mfacton/treadwall/README.md

# treadwall
Electronics for lightable rotating rockwall
