mfacton/treadwall/notes.txt

https://treadwallfitness.com/
very thin electronics (plates are close)
not too tall (plates fold next to eachother)
beware of screw holes for rock mounting

12V power rail regulated to 5V for each row
resistors for leds 5V-> around 3V
all wires connect daisy chained (easy to fit all types)

have boards on the side of the treadmil for easy maintinence
also possibly brushed design

center slip ring is a possibility too:
https://www.amazon.com/Wires-250RPM-0-600V-Turbine-Generator/dp/B07KT8VT49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

preferably 3 connectors: 2 for power 1 for communication
probably put a processor on the outer adapter board
use only arduinos for easy configuration by users

cheap 12V power supply (like laptop barrel jack connector)
https://www.amazon.com/LEDMO-Power-Supply-Transformers-Adapter/dp/B01461MOGQ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

2 shift registers for up to 10 leds per row

LED RGBW 80mA per channel: C7371891
38mA LED RGBW driver: C20622183

JST PH Connectors: C157929
JST PH Housing: C495663

cable current = 8*40mA = 500mA rated wires
could be JST XH or PH

48*8 = ~400 LEDS
PCBs are about 80$

Single LED = 0.045$(Driver) + 0.035$(LED) = 0.08$
Total LED = 400*0.08$ = 35$

Harnessing
Connectors = 400*2*0.02$ = 16$
Housings = 400*2*0.022$ = 20$
48*7*3 = ~1000 Precrimped Wires
Wire Cost = 225$(Digikey)
Wire Cost = 150$(alibaba)
https://www.aliexpress.us/item/3256804150631941.html

Total LED system cost
80$(PCB) + 35$(components) + 150$(harnessing)
Total = 300$
