mfacton/treadwall/pcb/light-board/light-board.kicad_pcb

## KiCad design pcb/light-board/light-board.kicad_pcb (2024-07-15)

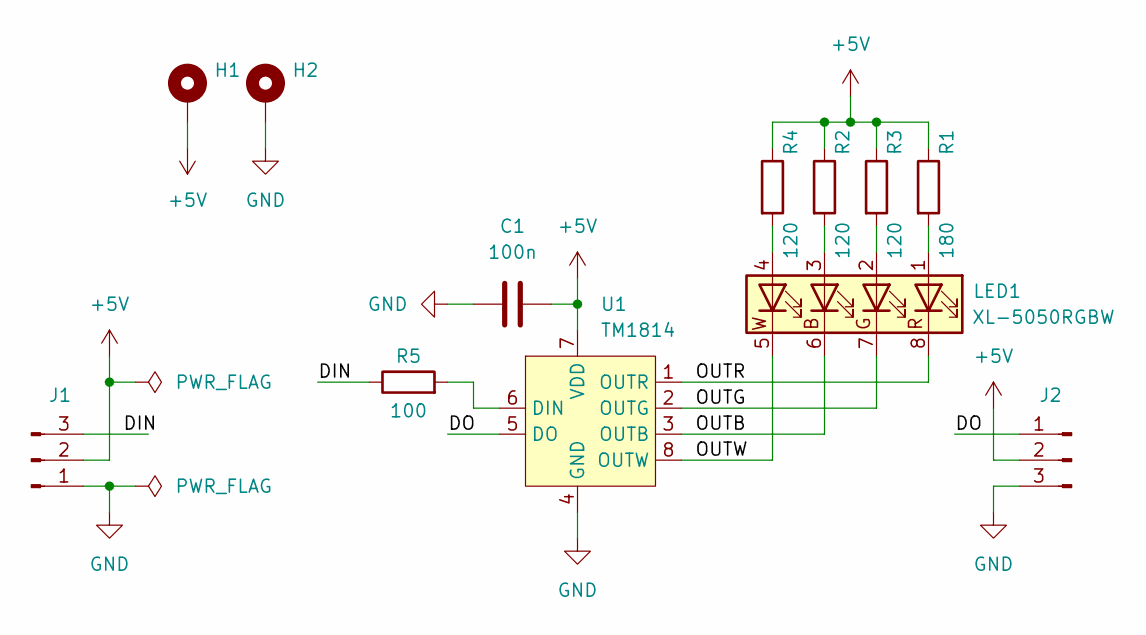
[picture p1: schematic light-board.kicad_sch]

Parts:
C1: 100n; C_0402_1005Metric; LCSC C1525
H1, H2: MountingHole_Pad; MountingHole_3.2mm_M3_Pad
J1, J2: Conn_01x03_Pin; JST_PH_S3B-PH-K_1x03_P2.00mm_Horizontal; LCSC C157929
LED1: XL-5050RGBW; LCSC C7371891
R1: 180; R_0603_1608Metric; LCSC C22828
R2, R3, R4: 120; R_0603_1608Metric; LCSC C22787
R5: 100; R_0402_1005Metric; LCSC C25076
U1: TM1814; SOP-8_3.9x4.9mm_P1.27mm; LCSC C20622183

Connections:
+5V: C1.2, H1.1, J1.2, J2.2, R1.1, R2.1, R3.1, R4.1, U1.7 (VDD)
/DIN: J1.3, R5.1
/DO: J2.1, U1.5 (DO)
/OUTB: LED1.6 (BK), U1.3 (OUTB)
/OUTG: LED1.7 (GK), U1.2 (OUTG)
/OUTR: LED1.8 (RK), U1.1 (OUTR)
/OUTW: LED1.5 (WK), U1.8 (OUTW)
GND: C1.1, H2.1, J1.1, J2.3, U1.4 (GND)
unnamed: LED1.3 (BA), R2.2
unnamed: LED1.2 (GA), R3.2
unnamed: LED1.1 (RA), R1.2
unnamed: LED1.4 (WA), R4.2
unnamed: R5.2, U1.6 (DIN)

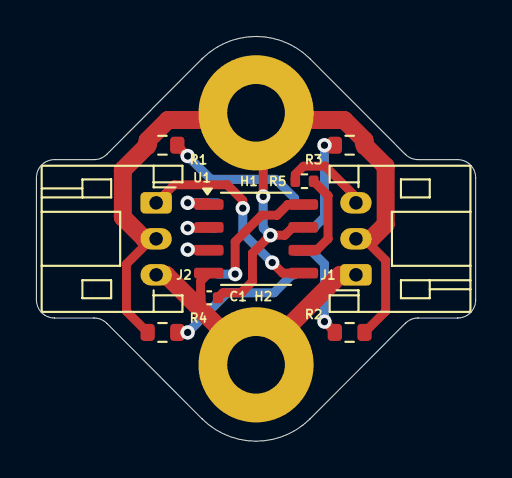
[picture p2: board light-board.kicad_pcb from above]

Board: 2 copper layers, 24.4 x 22.5 mm, 12 parts (1 on the bottom side), 13 nets.
