mfacton/treadwall/pcb/power-node/power-node.kicad_pcb

## KiCad design pcb/power-node/power-node.kicad_pcb (2024-07-11)

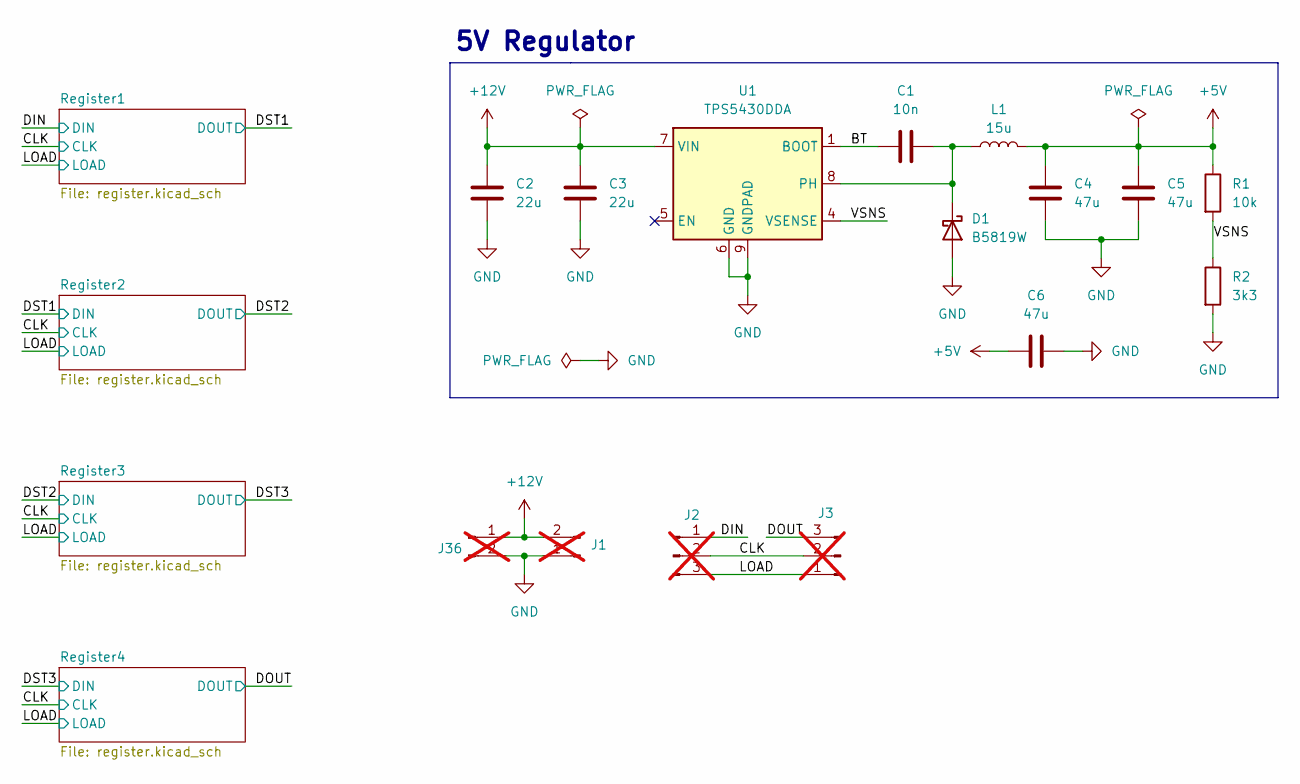
[picture p3: schematic power-node.kicad_sch]

Parts:
C1: 10n; C_0402_1005Metric; LCSC C15195
C2, C3: 22u; C_1206_3216Metric; LCSC C12891
C4, C5, C6: 47u; C_1206_3216Metric; LCSC C96123
D1: B5819W; D_SOD-123; LCSC C8598
J1, J36: Conn_01x02_Pin; WJ126V-5.0-2P; LCSC C8404; not fitted
J2, J3: Conn_01x03_Pin; PinHeader_1x03_P2.54mm_Vertical; not fitted
L1: 15u; L_Abracon_ASPI-0630LR; LCSC C177243
R1: 10k; R_0402_1005Metric; LCSC C25744
R2: 3k3; R_0402_1005Metric; LCSC C25890
U1: TPS5430DDA; TI_SO-PowerPAD-8_ThermalVias; LCSC C9864

Connections:
+5V: C4.1, C5.1, C6.1, L1.2, R1.1; also elsewhere on the board
+12V: C2.1, C3.1, J1.2, J36.1, U1.7 (VIN)
/BT: C1.1, U1.1 (BOOT)
/CLK: J2.2, J3.2; also elsewhere on the board
/DIN: J2.1; also elsewhere on the board
/DOUT: J3.3; also elsewhere on the board
/LOAD: J2.3, J3.1; also elsewhere on the board
/VSNS: R1.2, R2.1, U1.4 (VSENSE)
GND: C2.2, C3.2, C4.2, C5.2, C6.2, D1.2 (A), J1.1, J36.2, R2.2, U1.6 (GND), U1.9 (GNDPAD); also elsewhere on the board
unnamed: C1.2, D1.1 (K), L1.1, U1.8 (PH)

Notes on the sheet:
5V Regulator

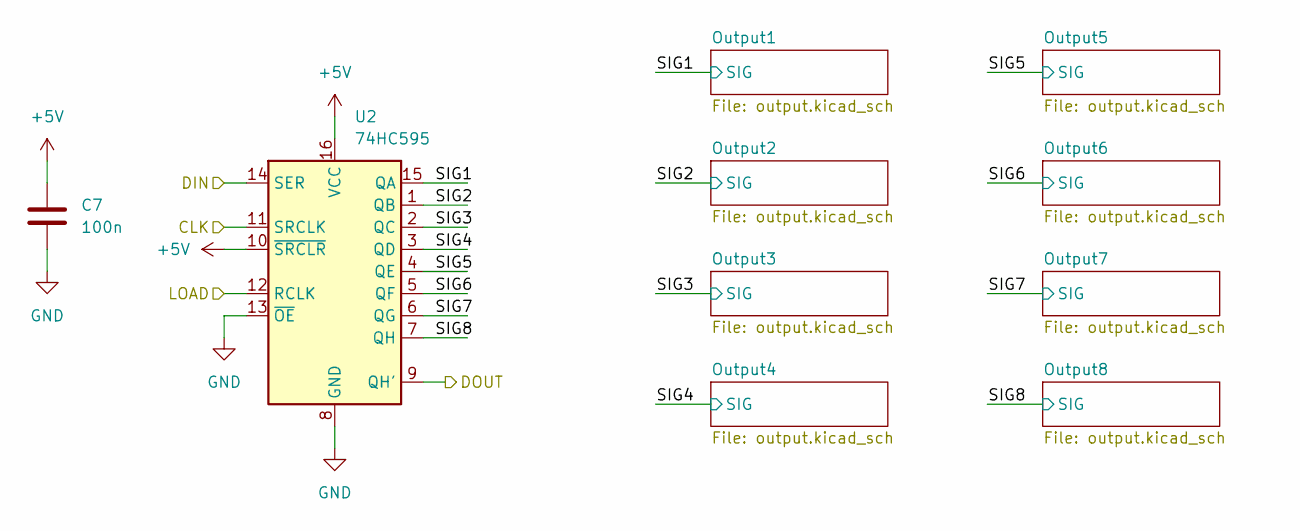
[picture p4: schematic register.kicad_sch]

Parts:
C7: 100n; C_0402_1005Metric; LCSC C1525
U2: 74HC595; SOIC-16_3.9x9.9mm_P1.27mm; LCSC C5947

Connections:
+5V: C7.1, U2.10 (~SRCLR), U2.16 (VCC); also elsewhere on the board
/CLK: U2.11 (SRCLK); also elsewhere on the board
/DIN: U2.14 (SER); also elsewhere on the board
/DST1: U2.9 (QH'); also elsewhere on the board
/LOAD: U2.12 (RCLK); also elsewhere on the board
/Register1/SIG1: U2.15 (QA); also elsewhere on the board
/Register1/SIG2: U2.1 (QB); also elsewhere on the board
/Register1/SIG3: U2.2 (QC); also elsewhere on the board
/Register1/SIG4: U2.3 (QD); also elsewhere on the board
/Register1/SIG5: U2.4 (QE); also elsewhere on the board
/Register1/SIG6: U2.5 (QF); also elsewhere on the board
/Register1/SIG7: U2.6 (QG); also elsewhere on the board
/Register1/SIG8: U2.7 (QH); also elsewhere on the board
GND: C7.2, U2.8 (GND), U2.13 (~OE); also elsewhere on the board

Parts of its further copies:
C8, C9, C10: 100n; C_0402_1005Metric; LCSC C1525
U3, U4, U5: 74HC595; SOIC-16_3.9x9.9mm_P1.27mm; LCSC C5947

Connections of its further copies:
+5V: C8.1, C9.1, C10.1, U3.10 (~SRCLR), U3.16 (VCC), U4.10 (~SRCLR), U4.16 (VCC), U5.10 (~SRCLR), U5.16 (VCC); also elsewhere on the board
/CLK: U3.11 (SRCLK), U4.11 (SRCLK), U5.11 (SRCLK); also elsewhere on the board
/DOUT: U5.9 (QH'); also elsewhere on the board
/DST1: U3.14 (SER); also elsewhere on the board
/DST2: U3.9 (QH'), U4.14 (SER)
/DST3: U4.9 (QH'), U5.14 (SER)
/LOAD: U3.12 (RCLK), U4.12 (RCLK), U5.12 (RCLK); also elsewhere on the board
/Register2/SIG1: U3.15 (QA); also elsewhere on the board
/Register2/SIG2: U3.1 (QB); also elsewhere on the board
/Register2/SIG3: U3.2 (QC); also elsewhere on the board
/Register2/SIG4: U3.3 (QD); also elsewhere on the board
/Register2/SIG5: U3.4 (QE); also elsewhere on the board
/Register2/SIG6: U3.5 (QF); also elsewhere on the board
/Register2/SIG7: U3.6 (QG); also elsewhere on the board
/Register2/SIG8: U3.7 (QH); also elsewhere on the board
/Register3/SIG1: U4.15 (QA); also elsewhere on the board
/Register3/SIG2: U4.1 (QB); also elsewhere on the board
/Register3/SIG3: U4.2 (QC); also elsewhere on the board
/Register3/SIG4: U4.3 (QD); also elsewhere on the board
/Register3/SIG5: U4.4 (QE); also elsewhere on the board
/Register3/SIG6: U4.5 (QF); also elsewhere on the board
/Register3/SIG7: U4.6 (QG); also elsewhere on the board
/Register3/SIG8: U4.7 (QH); also elsewhere on the board
/Register4/SIG1: U5.15 (QA); also elsewhere on the board
/Register4/SIG2: U5.1 (QB); also elsewhere on the board
/Register4/SIG3: U5.2 (QC); also elsewhere on the board
/Register4/SIG4: U5.3 (QD); also elsewhere on the board
/Register4/SIG5: U5.4 (QE); also elsewhere on the board
/Register4/SIG6: U5.5 (QF); also elsewhere on the board
/Register4/SIG7: U5.6 (QG); also elsewhere on the board
/Register4/SIG8: U5.7 (QH); also elsewhere on the board
GND: C8.2, C9.2, C10.2, U3.8 (GND), U3.13 (~OE), U4.8 (GND), U4.13 (~OE), U5.8 (GND), U5.13 (~OE); also elsewhere on the board

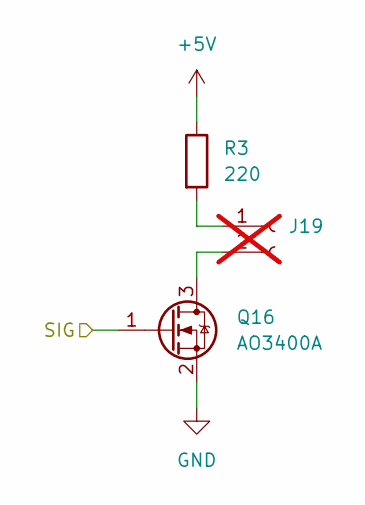
[picture p5: schematic output.kicad_sch]

Parts:
J19: Conn_01x02_Socket; PinHeader_1x02_P2.54mm_Vertical; not fitted
Q16: AO3400A; SOT-23; LCSC C20917
R3: 220; R_0603_1608Metric; LCSC C22962

Connections:
+5V: R3.1; also elsewhere on the board
/Register2/SIG3: Q16.1 (G); also elsewhere on the board
GND: Q16.2 (S); also elsewhere on the board
unnamed: J19.2, Q16.3 (D)

Parts of its further copies:
J4, J5, J6, J7, J8, J9, J10, J11, J12, J13, J14, J15, J16, J17, J18, J20, J21, J22, J23, J24, J25, J26, J27, J28, J29, J30, J31, J32, J33, J34, J35: Conn_01x02_Socket; PinHeader_1x02_P2.54mm_Vertical; not fitted
Q1, Q2, Q3, Q4, Q5, Q6, Q7, Q8, Q9, Q10, Q11, Q12, Q13, Q14, Q15, Q17, Q18, Q19, Q20, Q21, Q22, Q23, Q24, Q25, Q26, Q27, Q28, Q29, Q30, Q31, Q32: AO3400A; SOT-23; LCSC C20917
R4, R5, R6, R7, R8, R9, R10, R11, R12, R13, R14, R15, R16, R17, R18, R19, R20, R21, R22, R23, R24, R25, R26, R27, R28, R29, R30, R31, R32, R33, R34: 220; R_0603_1608Metric; LCSC C22962

Connections of its further copies:
+5V: R4.1, R5.1, R6.1, R7.1, R8.1, R9.1, R10.1, R11.1, R12.1, R13.1, R14.1, R15.1, R16.1, R17.1, R18.1, R19.1, R20.1, R21.1, R22.1, R23.1, R24.1, R25.1, R26.1, R27.1, R28.1, R29.1, R30.1, R31.1, R32.1, R33.1, R34.1; also elsewhere on the board
/Register1/SIG1: Q1.1 (G); also elsewhere on the board
/Register1/SIG2: Q2.1 (G); also elsewhere on the board
/Register1/SIG3: Q3.1 (G); also elsewhere on the board
/Register1/SIG4: Q4.1 (G); also elsewhere on the board
/Register1/SIG5: Q5.1 (G); also elsewhere on the board
/Register1/SIG6: Q6.1 (G); also elsewhere on the board
/Register1/SIG7: Q7.1 (G); also elsewhere on the board
/Register1/SIG8: Q8.1 (G); also elsewhere on the board
/Register2/SIG1: Q11.1 (G); also elsewhere on the board
/Register2/SIG2: Q12.1 (G); also elsewhere on the board
/Register2/SIG4: Q15.1 (G); also elsewhere on the board
/Register2/SIG5: Q14.1 (G); also elsewhere on the board
/Register2/SIG6: Q13.1 (G); also elsewhere on the board
/Register2/SIG7: Q10.1 (G); also elsewhere on the board
/Register2/SIG8: Q9.1 (G); also elsewhere on the board
/Register3/SIG1: Q19.1 (G); also elsewhere on the board
/Register3/SIG2: Q20.1 (G); also elsewhere on the board
/Register3/SIG3: Q24.1 (G); also elsewhere on the board
/Register3/SIG4: Q23.1 (G); also elsewhere on the board
/Register3/SIG5: Q22.1 (G); also elsewhere on the board
/Register3/SIG6: Q21.1 (G); also elsewhere on the board
/Register3/SIG7: Q18.1 (G); also elsewhere on the board
/Register3/SIG8: Q17.1 (G); also elsewhere on the board
/Register4/SIG1: Q27.1 (G); also elsewhere on the board
/Register4/SIG2: Q28.1 (G); also elsewhere on the board
/Register4/SIG3: Q32.1 (G); also elsewhere on the board
/Register4/SIG4: Q31.1 (G); also elsewhere on the board
/Register4/SIG5: Q30.1 (G); also elsewhere on the board
/Register4/SIG6: Q29.1 (G); also elsewhere on the board
/Register4/SIG7: Q26.1 (G); also elsewhere on the board
/Register4/SIG8: Q25.1 (G); also elsewhere on the board
GND: Q1.2 (S), Q2.2 (S), Q3.2 (S), Q4.2 (S), Q5.2 (S), Q6.2 (S), Q7.2 (S), Q8.2 (S), Q9.2 (S), Q10.2 (S), Q11.2 (S), Q12.2 (S), Q13.2 (S), Q14.2 (S), Q15.2 (S), Q17.2 (S), Q18.2 (S), Q19.2 (S), Q20.2 (S), Q21.2 (S), Q22.2 (S), Q23.2 (S), Q24.2 (S), Q25.2 (S), Q26.2 (S), Q27.2 (S), Q28.2 (S), Q29.2 (S), Q30.2 (S), Q31.2 (S), Q32.2 (S); also elsewhere on the board
unnamed: J4.2, Q1.3 (D)
unnamed: J5.1, R4.2
unnamed: J5.2, Q2.3 (D)
unnamed: J6.1, R5.2
unnamed: J6.2, Q3.3 (D)
unnamed: J7.1, R6.2
unnamed: J7.2, Q4.3 (D)
unnamed: J8.1, R7.2
unnamed: J8.2, Q5.3 (D)
unnamed: J9.1, R8.2
unnamed: J9.2, Q6.3 (D)
unnamed: J10.1, R9.2
unnamed: J10.2, Q7.3 (D)
unnamed: J11.1, R10.2
unnamed: J11.2, Q8.3 (D)
unnamed: J12.1, R11.2
unnamed: J12.2, Q9.3 (D)
unnamed: J13.1, R12.2
unnamed: J13.2, Q10.3 (D)
unnamed: J14.1, R13.2
unnamed: J14.2, Q11.3 (D)
unnamed: J15.1, R14.2
unnamed: J15.2, Q12.3 (D)
unnamed: J16.1, R15.2
unnamed: J16.2, Q13.3 (D)
unnamed: J17.1, R16.2
unnamed: J17.2, Q14.3 (D)
unnamed: J18.1, R17.2
unnamed: J18.2, Q15.3 (D)
unnamed: J20.1, R19.2
unnamed: J20.2, Q17.3 (D)
unnamed: J21.1, R20.2
unnamed: J21.2, Q18.3 (D)
unnamed: J22.1, R21.2
unnamed: J22.2, Q19.3 (D)
unnamed: J23.1, R22.2
unnamed: J23.2, Q20.3 (D)
unnamed: J24.1, R23.2
unnamed: J24.2, Q21.3 (D)
unnamed: J25.1, R24.2
unnamed: J25.2, Q22.3 (D)
unnamed: J26.1, R25.2
unnamed: J26.2, Q23.3 (D)
unnamed: J27.1, R26.2
unnamed: J27.2, Q24.3 (D)
unnamed: J28.1, R27.2
unnamed: J28.2, Q25.3 (D)
unnamed: J29.1, R28.2
unnamed: J29.2, Q26.3 (D)
unnamed: J30.1, R29.2
unnamed: J30.2, Q27.3 (D)
unnamed: J31.1, R30.2
unnamed: J31.2, Q28.3 (D)
unnamed: J32.1, R31.2
unnamed: J32.2, Q29.3 (D)
unnamed: J33.1, R32.2
unnamed: J33.2, Q30.3 (D)
unnamed: J34.1, R33.2
unnamed: J34.2, Q31.3 (D)
unnamed: J35.1, R34.2
unnamed: J35.2, Q32.3 (D)

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
Board: 2 copper layers, 119 parts (0 on the bottom side), 109 nets, no tracks yet.
