mfacton/treadwall/stm32/control-dev/control-dev.ioc

Mcu.UserName=STM32F446RETx
PA13.Signal=SYS_JTMS-SWDIO
PA14.Signal=SYS_JTCK-SWCLK
PA5.GPIO_Label=LD2
PA5.Signal=GPIO_Output
PA7.Signal=TIM1_CH1N
PB3.Signal=SYS_JTDO-SWO
PH0-OSC_IN.Signal=RCC_OSC_IN
PH1-OSC_OUT.Signal=RCC_OSC_OUT
