mfacton/treadwall/(commit log)

2024-07-11 Create initial schematic
    [output.kicad_sch, power-node.kicad_pcb, power-node.kicad_sch, register.kicad_sch]
2024-07-15 Finish pcb for production
    [bom.csv, designators.csv, light-board.kicad_pcb, light-board.kicad_sch, positions.csv]
2024-09-04 Ignore stm32 files
